thijser/robotica-minor-5/LaTeX/Voorkant_verslag.pdf

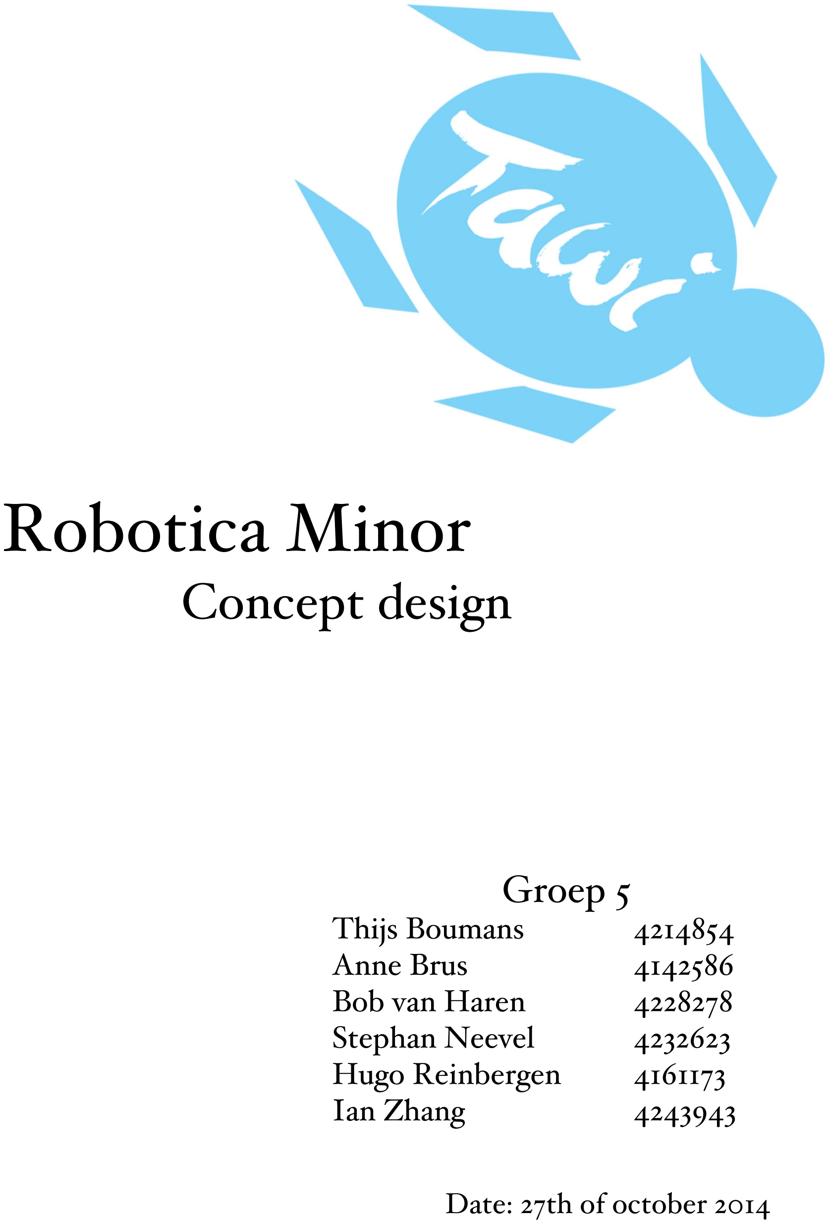
[picture p63: page 1]

# RoboticaM inor

## Concept design

### Groep 5

T hijs Boum ans | 4 214 854
A nne Brus | 414 2586
Bob vanHaren | 4 228278
StephanNeevel | 4 2326 23
Hugo Reinberg en | 4161173
IanZhang | 4 24 394 3

Date:27th ofoctober20 14
