thijser/robotica-minor-5/LaTeX/Images/calculations_mouth.pdf

'' 1

L

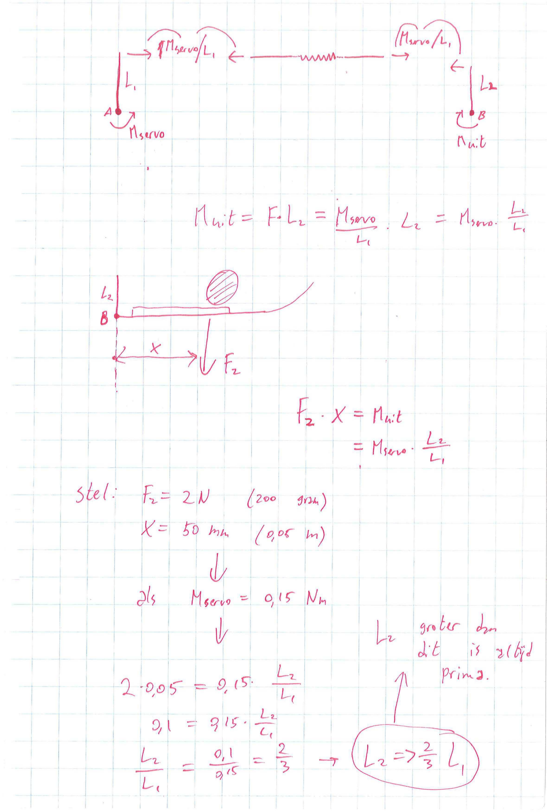
[picture p64: page 1]

— \AAAA /
\AAAA / | f | 4-
u

. L

### A \ l/V O

t

u

. L
lA. (/

# ' ri u 11

(

— | ' ri | u

(

I V | L
u
- \

•
F.
r

# T • \u .it

/ .

f - / -

# [zoo

f - / | - | 1 | 1 Zp | [zoo
1 1 ^'
. | or
J/

i r
ll/
lit ,
O r\ | \ | f

If

JO
U 0 I
i | il l | z
r ^
1 | I

1
