thijser/robotica-minor-5/LaTeX/Images/springproof.pdf

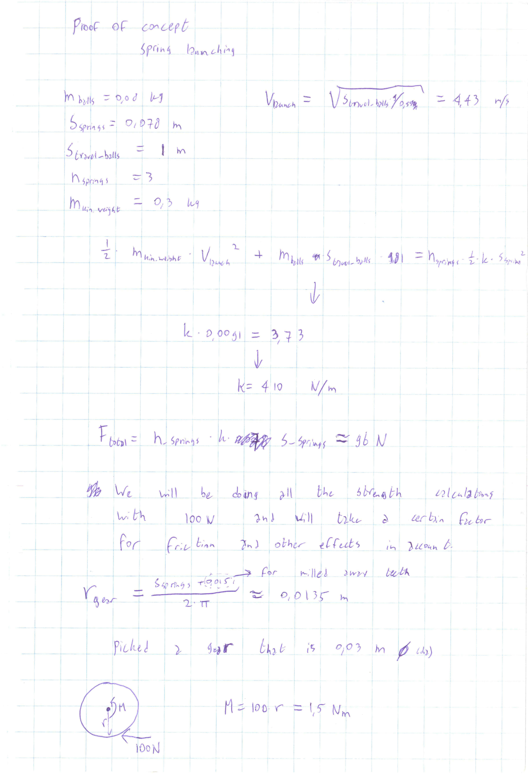
[picture p65: page 1]

of | IP h
H | I | — | ^
lA*) * | -
\ 1

;> it

- h | h | J-

)

3

J
k

f

f t

i | v. :.|L

](

:.|L | I | I
]( | tl

I

fo r | 1 | ohhc

V
> | , | A | tto-

l l

J >
}

100 A

)'
