thijser/robotica-minor-5/LaTeX/Images/truckproof.pdf

\ .

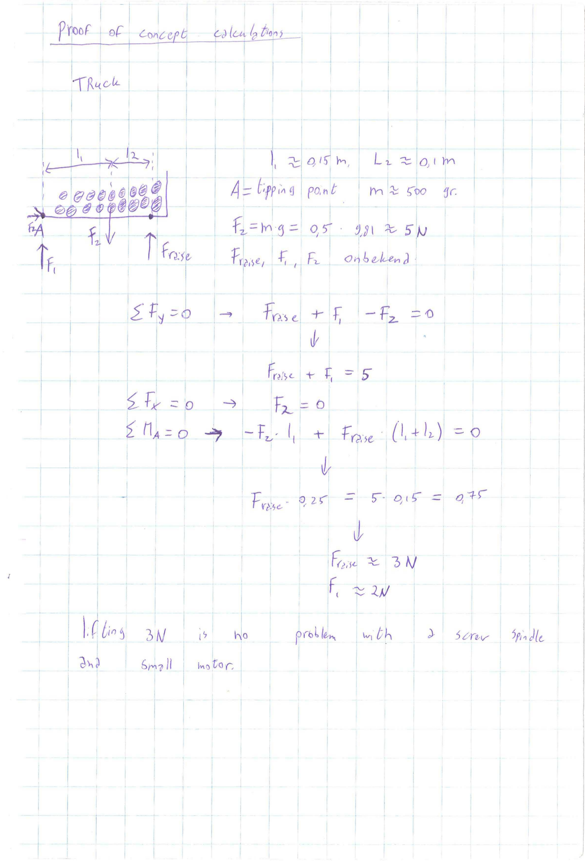
[picture p66: page 1]

i 4 ^'< i >

\ | Q.IS | L

f >^
(
| Q.IS | L
' 11 'J | po, tl | oo \r.
\ | / | U l • ^ 5" KJ • ^ 5" KJ
s | / | * V
f, | F.
r
i f | 2- "

5-
if . 0
- 1,

^ 0

-F , • 1, | Or
J
li/

O, ( i

l

f, ^ | f
if | KI | 0 | f | ^

•

1
