thijser/robotica-minor-5/beaglebone_headers.jpg

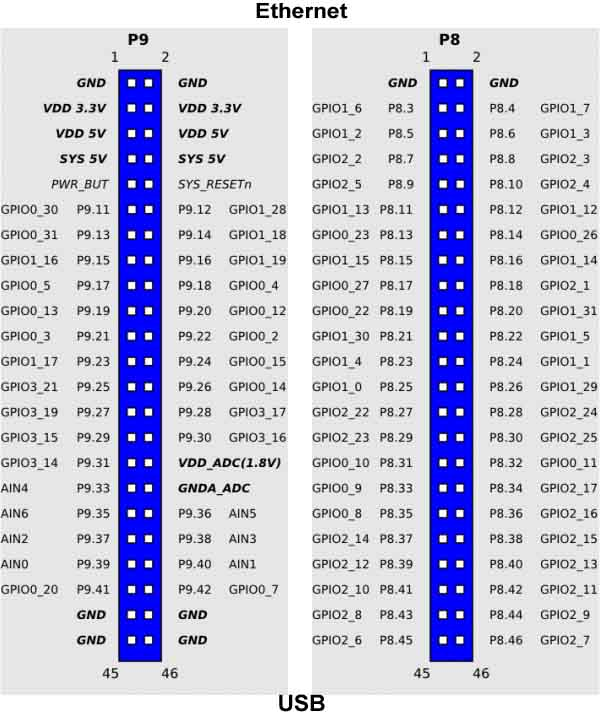
beaglebone_headers.jpg
