thijser/robotica-minor-5/LaTeX/Images/BOM.pdf

Part number | Part name | Dealer | Qty/size | Price/unit (ex. Btw) | Price total
404748 | WormWiel Gearbox 3Nm | Eisses | 1 | 42,3 | € 42,30
T1060 | Trekveer | Alcomex | 3 | 2,45 | € 7,35
9901957 | Microswitch tandheugel | Farnell | 1 | 0,924 | € 0,92
2422228 | Beaglebone black | Farnell | 1 | 47,44 | € 47,44
458599 | Tandwiel M1 30T | ATD | 1 | 3,79 | € 3,79
458039 | Tandheugel M1 500mm | ATD | 1 | 8,93 | € 8,93
83111240 | LCD Screen | iPrototype | 1 | 22,95 | € 22,95
206040 - 89 | NiMh accu 3700mAh, 12V, 45*22*218mm | Conrad | 1 | 44,99 | € 44,99
HE0216-220 | RFID tag sticker 25mm dia. | HobbyElectronica | 20 | 0,95 | € 19,00
801144 | Styropor bal 50mm | Rienda | 20 | 0,12 | € 2,40
HE0136-210 | RFID Reader | HobbyElectronica | 1 | 9,95 | € 9,95
506167 | Trust Bluetooth 3.0 USB Adapter | Dixons | 1 | 9,99 | € 9,99
474-6168 | Timing belt contitech 16 /T5 /550 SS | rs online | 1 | 16,96 | € 16,96
286-5742 | Timing belt pulley aluminium suit belt width 16 | rs online | 2 | 10,58 | € 21,16
298-5391 | DC Geared motor, brushed 6 volt dc 8Ncm 13 rpm | rs online | 1 | 24,82 | € 24,82
586682 | Hoekanker met ril | gamma | 2 | 1,25 | € 2,50
no number | Kitelijn 275kg per meter | CheapKiteLines | 2 | 0,37 | € 0,74
1400-06307X | PVC buis meterstuk [63*2.0] | pvc online | 1 | 2,65 | € 2,65
1426-063063 | PVC T stuk 45 graden [63*63*63] | pvc online | 1 | 10,68 | € 10,68
770-3006 | Hinge 30*30*3 | rs online | 2 | 4,57 | € 9,14
275460 - 89 | Microservo | Conrad | 1 | 5,99 | € 5,99
| PVC Buis 160*2,5 | | 1 | 20 | € 20,00
| PMB Parts | | qty/size/surface
11104 | Glijlager PMB 6-9-11 | PMB | 4 | 0,18 | € 0,72
11105 | Glijlager PMB 8-11-13 | PMB | 3 | 0,2 | € 0,60
11102 | Glijlager PMB 4-6-8 | PMB | 2 | 0,17 | € 0,34
| Perspex plaat 4mm [300*300mm] | Bouwkunde | 0,09 | 105,04 | € 9,45
| Perspex plaat 8mm [600*300mm] | Bouwkunde | 0,18 | 199,87 | € 35,98
71905 | Asborgring PMB 6mm | PMB | 4 | 0,03 | € 0,12
71907 | Asborgring PMB 8mm | PMB | 2 | 0,06 | € 0,12

72115 | Afstandsbus 5,2x10x8 | PMB
| | 1 | 0,08 | € 0,08
60306 | MDF 18 (16 platen van 0.50x0.50) | PMB
| | 4 | 13,4 | € 53,60
30305 | Alu Rondstaf 10 | 0,1 | 1,22 | € 0,12
30305 | Alu Rondstaf 10 | 0,11 | 1,22 | € 0,13
30305 | Alu Rondstaf 10 | 0,12 | 1,22 | € 0,15
30303 | Alu Rondstaf 6 | 0,14 | 0,43 | € 0,06
30217 | Alu Platstaf 20x8 | 0,015 | 2,08 | € 0,03
30405 | Alu Vierkantstaf 25 | 0,02 | 8,57 | € 0,17
30405 | Alu Vierkantstaf 25 | 0,02 | 8,57 | € 0,17
30408 | Alu Vierkantstaf 40 | 0,04 | 21,9 | € 0,88
30408 | Alu Vierkantstaf 40 | 0,02 | 21,9 | € 0,44
30403 | Alu vierkantstaf 15 | 0,04 | 3,09 | € 0,12
30402 | Alu vierkantstaf 10 | 0,06 | 1,38 | € 0,08
30402 | Alu vierkantstaf 10 | 0,1 | 1,38 | € 0,14
30113 | Alu plaat 20 | 0,0072 | 452,03 | € 3,25
30112 | Alu plaat 15 | 0,0128 | 338,82 | € 4,34
30112 | Alu plaat 15 | 0,004 | 338,82 | € 1,36
30112 | Alu plaat 15 | 0,0063 | 338,82 | € 2,13
30110 | Alu plaat 4 | 0,0168 | 81,93 | € 1,38
30105 | Alu plaat 2 | 0,0036 | 29,39 | € 0,11
30105 | Alu plaat 2 | 0,056 | 29,39 | € 1,65
30105 | Alu plaat 2 | 0,0056 | 29,39 | € 0,16
30105 | Alu plaat 2 | 0,0168 | 29,39 | € 0,49
30105 | Alu plaat 2 | 0,0176 | 29,39 | € 0,52
30105 | Alu plaat 2 | 0,0068 | 29,39 | € 0,20
30105 | Alu plaat 2 | 0,0014 | 29,39 | € 0,04
30601 | Alu Buis 15*15*1,5 | 0,035 | 1,44 | € 0,05
30601 | Alu Buis 15*15*1,5 | 0,2 | 1,44 | € 0,29
30601 | Alu Buis 15*15*1,5 | 0,25 | 1,44 | € 0,36
30601 | Alu Buis 15*15*1,5 | 0,25 | 1,44 | € 0,36
30601 | Alu Buis 15*15*1,5 | 0,5 | 1,44 | € 0,72
30601 | Alu Buis 15*15*1,5 | 0,28 | 1,44 | € 0,40
30601 | Alu Buis 15*15*1,5 | 0,29 | 1,44 | € 0,42

50503 | POM plaat 20 | 0,00375 | 897,51 | € 3,37
50503 | POM plaat 20 | 0,003 | 897,51 | € 2,69
51202 | Nitril rubber 2mm | 0,02 | 26,3 | € 0,53
51106 | PS Foam 625*600*80 | 3 | 5,36 | € 16,08

## Own Parts

USB Sound card | Hugo
| | 1 | 0 | € 0,00
Bob's 5 mm perspex plaat [80*60mm] | bob | 0,0048
| | | 0 | € 0,00
Resin en glassfiber voor schild (via kennis) | Anne | € 50,00

# Maybe's:

| Askoppeling 8mm->8mm
| Askoppeling 6mm->4mm
total | € 529,05
