thijser/robotica-minor-5/LaTeX/Images/PartList.pdf

ITEM NO. | PART NUMBER | DESCRIPTION | QTY.
1 | Pioneer-1_Doosje | | 1
2 | MotorWiel_und_enco
der | 2
3 | Afschietbuis | | 1
4 | Wheel_Drive | | 2
5 | Assembly_caster | | 1
6 | Slider_Platform | | 1
7 | containment_ring | | 1
8 | improved_slider_rack
V2 | 1
9 | Top_Cover | | 1
10 | accupack | | 1
11 | BijnaUBeugel | | 2
12 | transportbuis | | 1
13 | pulley 27 T5 12-2 | | 1
14 | Timing belt 16 T5 550 | | 1
15 | Ball | 1
16 | rubber stripje | | 8
17 | T-stuk afgesneden | | 1
18 | nek | 1
19 | motor | | 1
20 | staander achter | | 2
21 | staander voor | | 1
22 | ligger | | 1
23 | ligger platstaf | | 1
24 | ligger 2 | | 1
25 | plaatje voorkant | | 1
26 | ring | 1
27 | Motor-404748-KGK | | 1
28 | motormount | | 1
29 | staander voor rechts | | 1
30 | blokje | | 1
31 | blokje voor
| bevestiging frame | | 4
32 | motordakje | | 1
33 | ISO 1580 - M4 x 10 ---
10N | 8
34 | ISO 1580 - M4 x 40 ---
40N | 5
35 | ISO 1580 - M4 x 20 ---
20N | 4

36 ISO 1580 - M4 x 25 ---
25N

2

37 ISO 1580 - M3 x 10 ---
10N

2

38 ISO 1580 - M3 x 16 ---
16N

2

39 hinge30x30x3

8
40 hinge30x30x3As

4
41 fixatie_pvc_onder

1
42 | ISO 7046-1 - M3 x 10 -
Z --- 10N | 14
43 | ISO 7046-1 - M4 x 16 -
Z --- 16N

4

44 ISO 7046-1 - M3 x 20 -
Z --- 20N

2

45 | Hexagon Nut ISO -
4032 - M3 - D - N | 18
46 | Hexagon Nut ISO -
4032 - M4 - D - N | 15
47 | ligger rechts

1
48 ondersteuningBuis

2
49 hoekanker 90 90
gamma links

1

50 hoekanker 90 90
gamma rechts

1

51 pulley 27 T5 12-2
onder

1

52 ISO 10673-3.2-S

4
53 as pulley beneden

1
54 ISO 7045 - M3 x 8 - Z ---8N

1

55 vierkantas

1
56 Bearing

1
57 Acople Flexible

1
58 Pulleyblockassembly

1
59 assembly_hoofd

1
60 Shell

1
61 shell_fastener

2
62 new_lagerhuis

2
63 glijlager_6_9_11

4
64 axle upper

1
65 houder as boven

2
66 motorbevestiging

1

67 motorhouder_achter

1
68 Acople FlexibleSLDPRT

1
69 B27.7M - 3AM1-6

2
