thijser/robotica-minor-5/(threads)

Thread 2 (2015-01-22):

.save bestanden verwijderen

jensdewaard, 2015-01-22:
Jullie hebben heel veel .save bestanden (tijdelijke bestanden van de nano editor). Dit is raar en zorgt voor een onoverzichtelijke repository. Verwijderen!

bvanharen, 2015-01-22:
Jens ga even je groepsgenoten vervelen ofzo
On 22 Jan 2015 23:45, Jens de Waard <notifications@github.com> wrote:Jullie hebben heel veel .save bestanden (tijdelijke bestanden van de nano editor). Dit is raar en zorgt voor een onoverzichtelijke repository. Verwijderen!

—Reply to this email directly or view it on GitHub.

jensdewaard, 2015-01-22:
Sorry knapperd, ik ben nog niet klaar! Ik heb nog niet eens naar jouw code gekeken.

bvanharen, 2015-01-22:
Haha your eyes will burn. Good luck
On 22 Jan 2015 23:55, Jens de Waard <notifications@github.com> wrote:Sorry knapperd, ik ben nog niet klaar! Ik heb nog niet eens naar jouw code gekeken.

—Reply to this email directly or view it on GitHub.
