thijser/robotica-minor-5/LaTeX/pdfdrawings/Afschietbuis.PDF

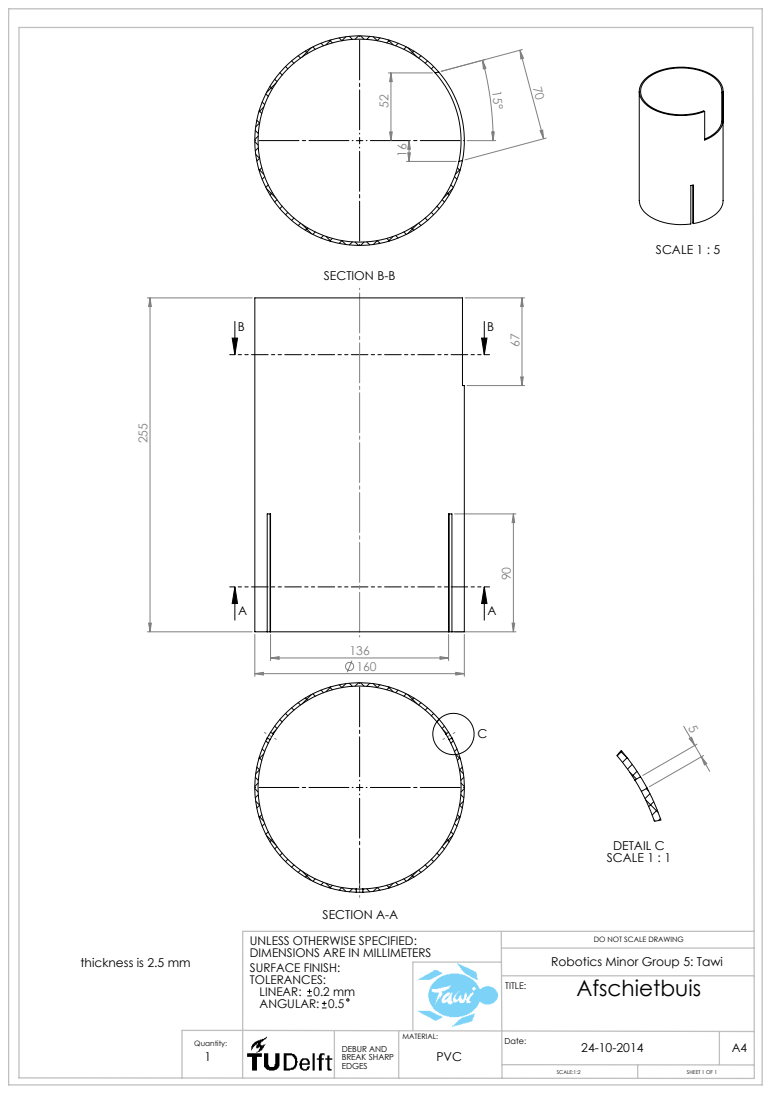
[picture p68: page 1]
SECTION A-A; SCALE 1 : 5; SECTION B-B; DETAIL C SCALE 1 : 1; LINEAR:

UNLESS OTHERWISE SPECIFIED:
DIMENSIONS ARE IN MILLIMETERS
SURFACE FINISH:
TOLERANCES:

DO NOT SCALE DRAWING
Robotics Minor Group 5: Tawi
Afschietbuis

thickness is 2.5 mm

1 | | DEBUR AND BREAK SHARP EDGES | MATERIAL: PVC | Date: 24-10-2014 Quantity: | A4

SCALE:1:2 | SHEET 1 OF 1
