thijser/robotica-minor-5/LaTeX/pdfdrawings/as_pulley_beneden.PDF

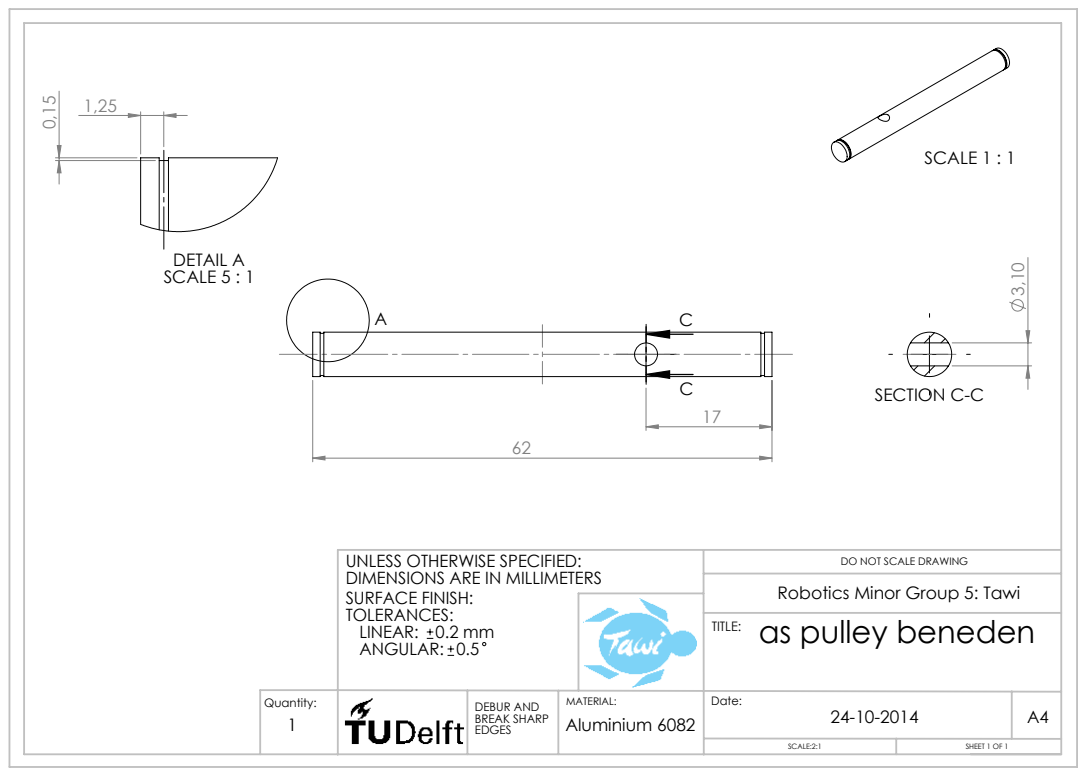
[picture p69: page 1]
DETAIL A SCALE 5 : 1; SECTION C-C; SCALE 1 : 1; LINEAR:

UNLESS OTHERWISE SPECIFIED:
DIMENSIONS ARE IN MILLIMETERS
SURFACE FINISH:
TOLERANCES:

DO NOT SCALE DRAWING
Robotics Minor Group 5: Tawi
as pulley beneden
TITLE:

Quantity: 1 | | DEBUR AND BREAK SHARP EDGES | MATERIAL: Aluminium 6082 | Date: 24-10-2014 | A4

SCALE:2:1 | SHEET 1 OF 1
