thijser/robotica-minor-5/LaTeX/pdfdrawings/blokje.PDF

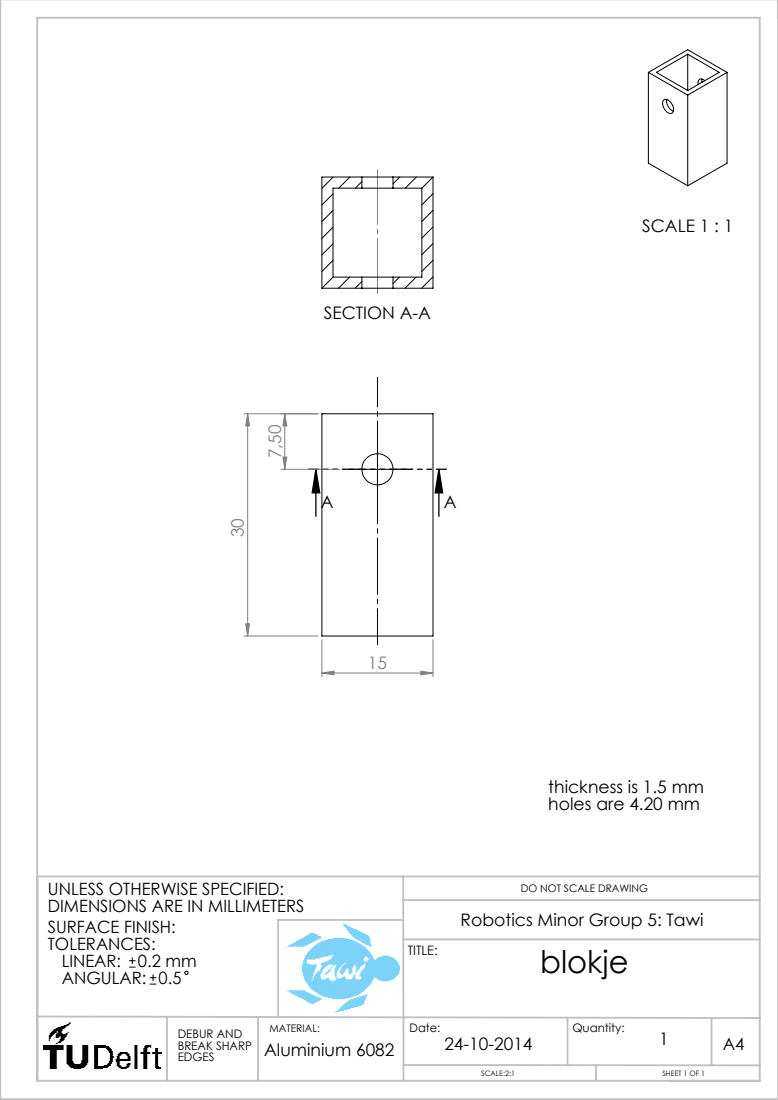
[picture p70: page 1]
SECTION A-A; SCALE 1 : 1; LINEAR:

thickness is 1.5 mm
holes are 4.20 mm

UNLESS OTHERWISE SPECIFIED:
DIMENSIONS ARE IN MILLIMETERS
SURFACE FINISH:
TOLERANCES:

DO NOT SCALE DRAWING
Robotics Minor Group 5: Tawi
blokje

DEBUR AND BREAK SHARP EDGES | MATERIAL: Aluminium 6082 | Date: 24-10-2014 | Quantity: 1 | A4

SCALE:2:1 | SHEET 1 OF 1
