thijser/robotica-minor-5/LaTeX/pdfdrawings/Horizontal_bar_front.PDF

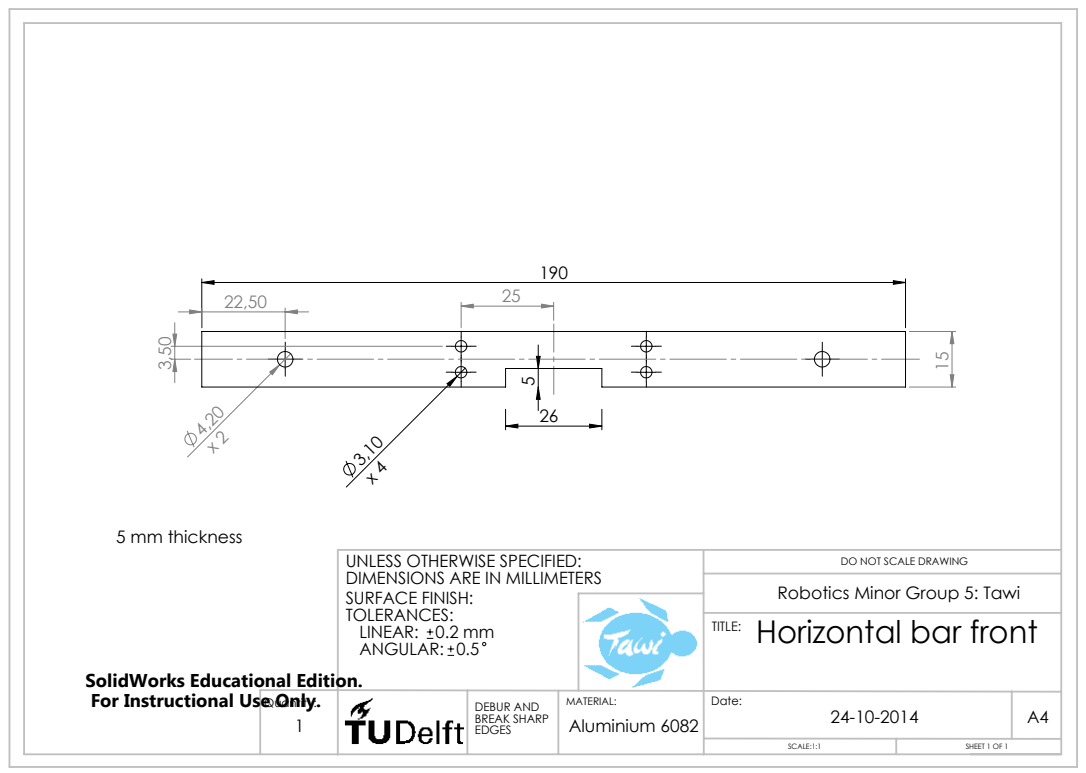
[picture p71: page 1]
5 mm thickness; LINEAR:

UNLESS OTHERWISE SPECIFIED:
DIMENSIONS ARE IN MILLIMETERS
SURFACE FINISH:
TOLERANCES:

DO NOT SCALE DRAWING
Robotics Minor Group 5: Tawi
Horizontal bar front
TITLE:

SolidWorks Educational Edition.
For Instructional Use Only.

Quantity: 1 | | DEBUR AND BREAK SHARP EDGES | MATERIAL: Aluminium 6082 | Date: 24-10-2014 | A4

SCALE:1:1 | SHEET 1 OF 1
