thijser/robotica-minor-5/LaTeX/pdfdrawings/houder_as_boven.PDF

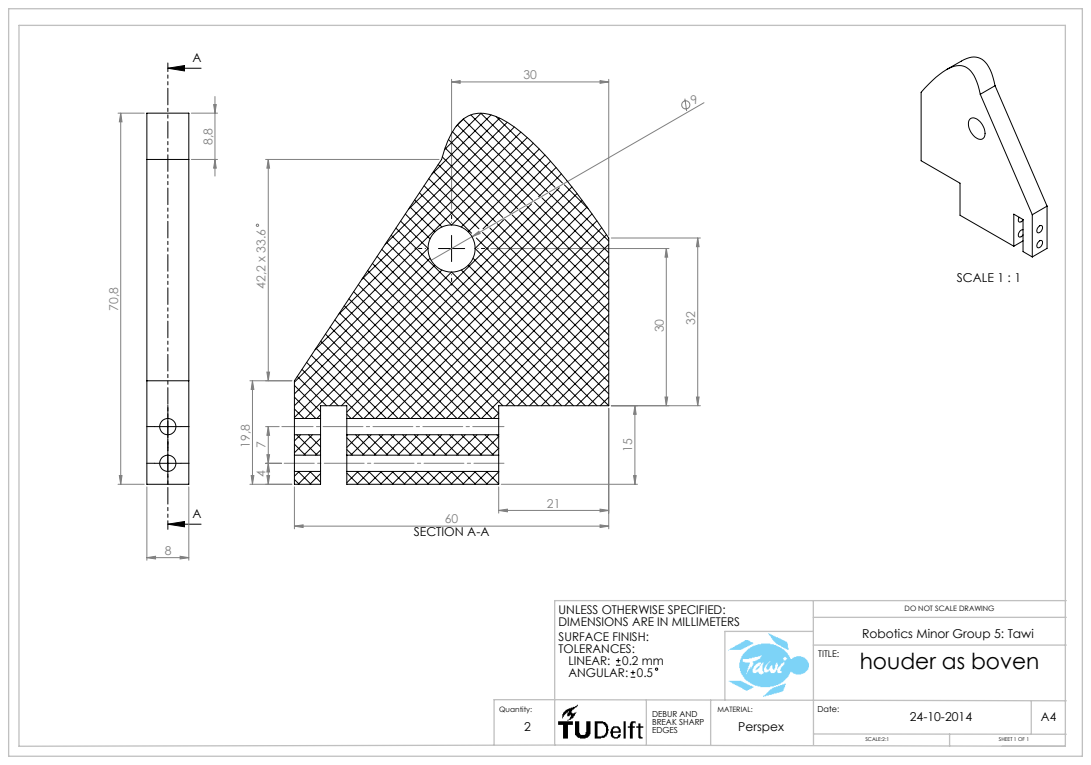
[picture p72: page 1]
SECTION A-A; SCALE 1 : 1; LINEAR:

UNLESS OTHERWISE SPECIFIED:
DIMENSIONS ARE IN MILLIMETERS
SURFACE FINISH:
TOLERANCES:

DO NOT SCALE DRAWING
Robotics Minor Group 5: Tawi
houder as boven

2 | | DEBUR AND BREAK SHARP EDGES | MATERIAL: Perspex | Date: 24-10-2014 Quantity: | A4

SCALE:2:1 | SHEET 1 OF 1
