thijser/robotica-minor-5/LaTeX/pdfdrawings/ligger.PDF

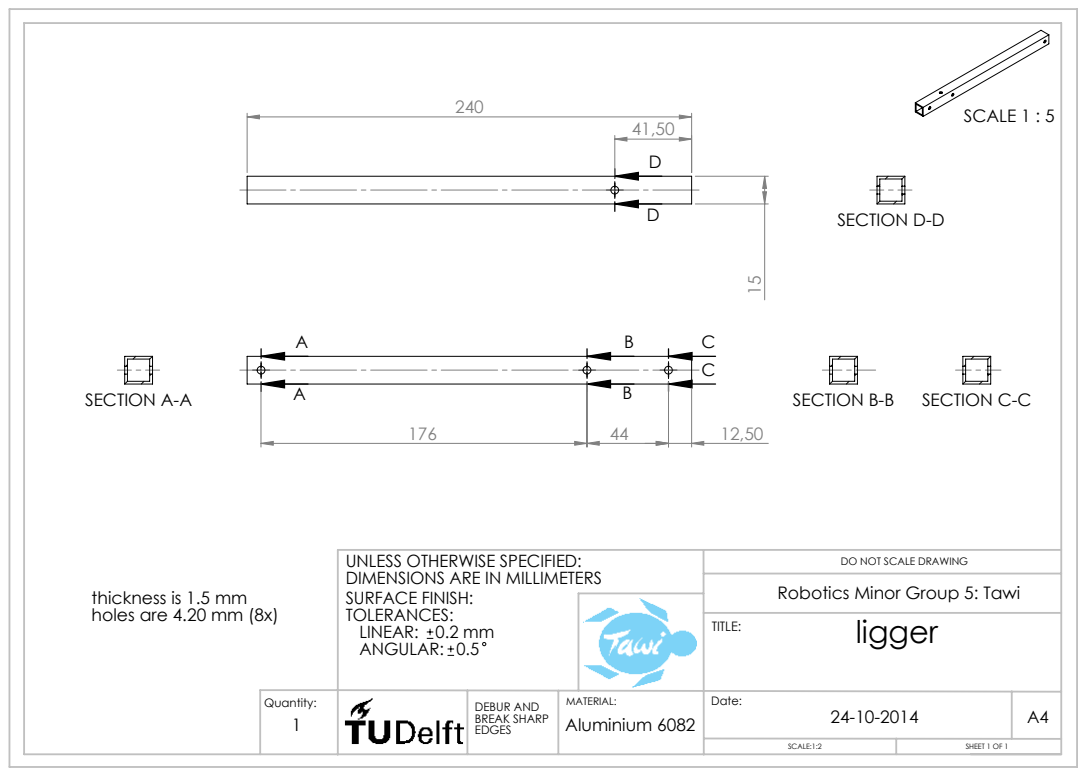
[picture p73: page 1]
SECTION A-A; SECTION B-B SECTION C-C; SECTION D-D; SCALE 1 : 5; holes are 4.20 mm (8x); ligger; LINEAR:

UNLESS OTHERWISE SPECIFIED:
DIMENSIONS ARE IN MILLIMETERS
SURFACE FINISH:
TOLERANCES:

DO NOT SCALE DRAWING
Robotics Minor Group 5: Tawi

thickness is 1.5 mm

Quantity: 1 | | DEBUR AND BREAK SHARP EDGES | MATERIAL: Aluminium 6082 | Date: 24-10-2014 | A4

SCALE:1:2 | SHEET 1 OF 1
