thijser/robotica-minor-5/LaTeX/pdfdrawings/ligger_2.PDF

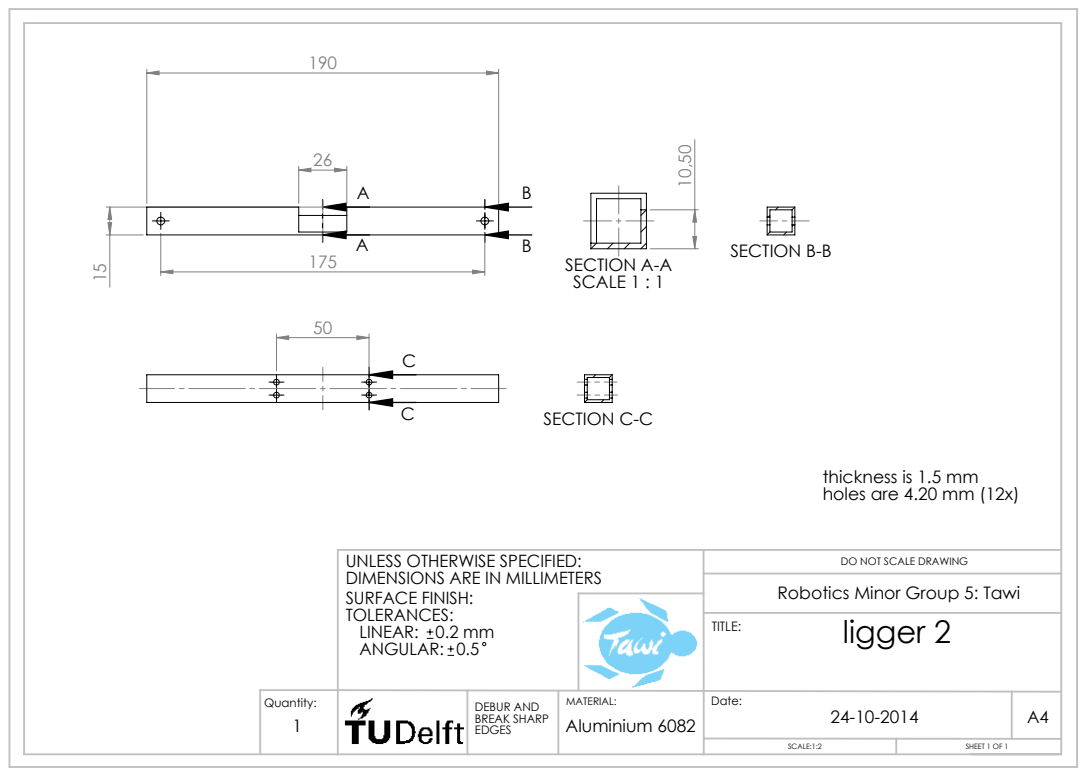
[picture p74: page 1]
SECTION A-A SCALE 1 : 1; SECTION B-B; SECTION C-C; LINEAR:

thickness is 1.5 mm
holes are 4.20 mm (12x)

UNLESS OTHERWISE SPECIFIED:
DIMENSIONS ARE IN MILLIMETERS
SURFACE FINISH:
TOLERANCES:

DO NOT SCALE DRAWING
Robotics Minor Group 5: Tawi
ligger 2

Quantity: 1 | | DEBUR AND BREAK SHARP EDGES | MATERIAL: Aluminium 6082 | Date: 24-10-2014 | A4

SCALE:1:2 | SHEET 1 OF 1
