thijser/robotica-minor-5/LaTeX/pdfdrawings/ligger_rechts.PDF

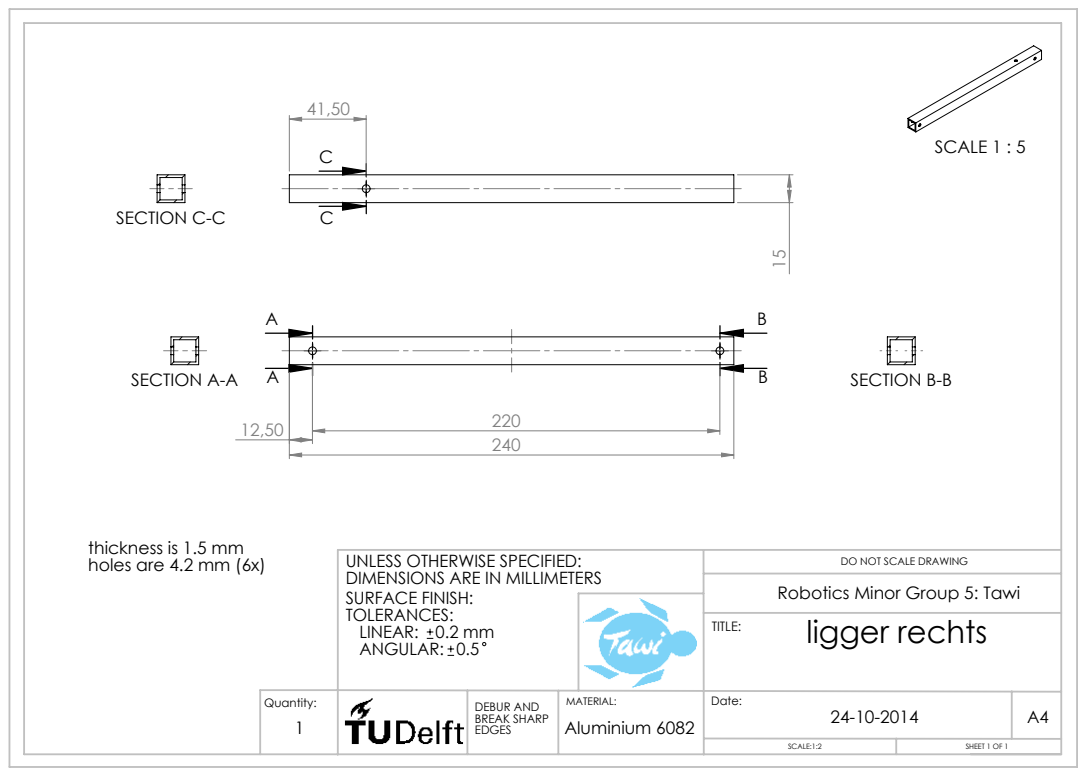
[picture p75: page 1]
SECTION A-A; SECTION B-B; SECTION C-C; SCALE 1 : 5; LINEAR:

thickness is 1.5 mm
holes are 4.2 mm (6x)

UNLESS OTHERWISE SPECIFIED:
DIMENSIONS ARE IN MILLIMETERS
SURFACE FINISH:
TOLERANCES:

DO NOT SCALE DRAWING
Robotics Minor Group 5: Tawi
ligger rechts

Quantity: 1 | | DEBUR AND BREAK SHARP EDGES | MATERIAL: Aluminium 6082 | Date: 24-10-2014 | A4

SCALE:1:2 | SHEET 1 OF 1
