thijser/robotica-minor-5/LaTeX/pdfdrawings/motorbevestiging.PDF

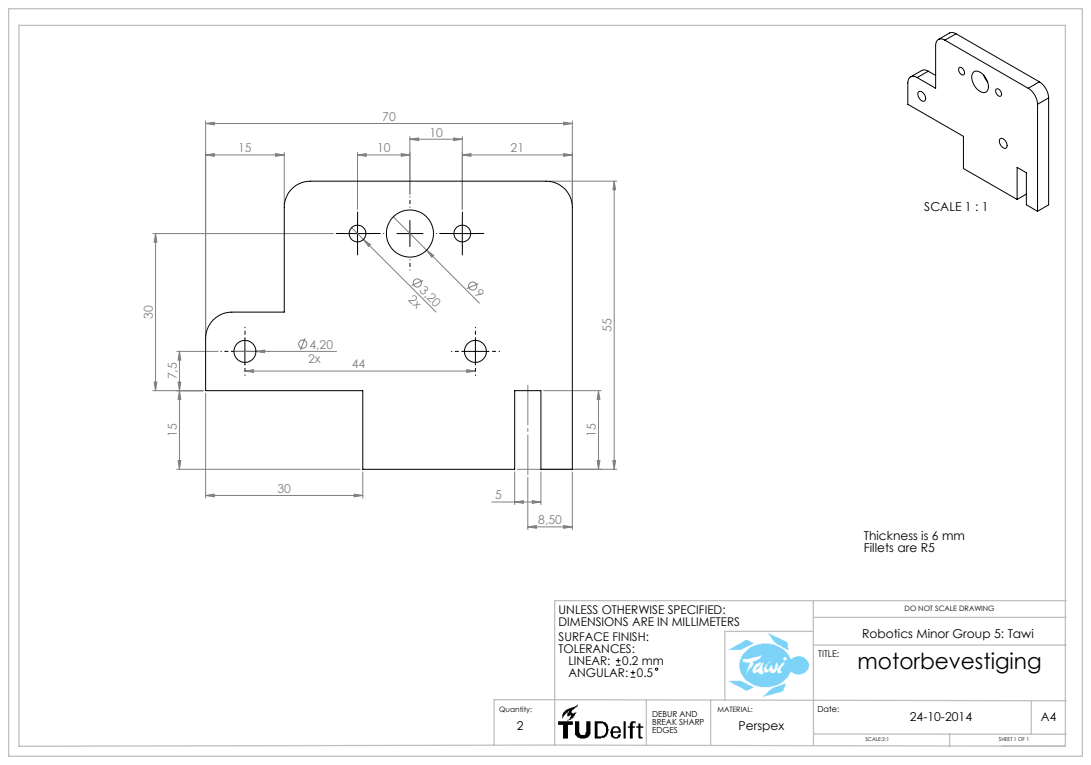
[picture p76: page 1]
SCALE 1 : 1; LINEAR:

Thickness is 6 mm
Fillets are R5

UNLESS OTHERWISE SPECIFIED:
DIMENSIONS ARE IN MILLIMETERS
SURFACE FINISH:
TOLERANCES:

DO NOT SCALE DRAWING
Robotics Minor Group 5: Tawi
motorbevestiging

2 | | DEBUR AND BREAK SHARP EDGES | MATERIAL: Perspex | Date: 24-10-2014 Quantity: | A4

SCALE:2:1 | SHEET 1 OF 1
