thijser/robotica-minor-5/LaTeX/pdfdrawings/motorhouder_achter.PDF

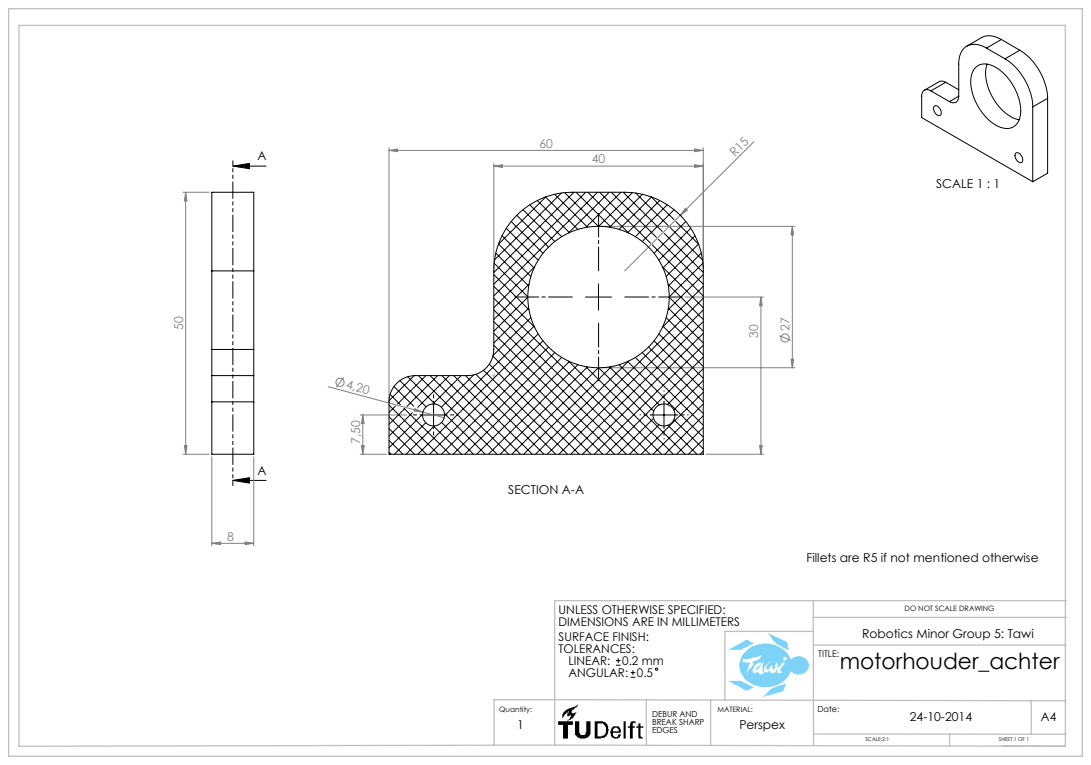
[picture p77: page 1]
SECTION A-A; SCALE 1 : 1; LINEAR:

Fillets are R5 if not mentioned otherwise

UNLESS OTHERWISE SPECIFIED:
DIMENSIONS ARE IN MILLIMETERS
SURFACE FINISH:
TOLERANCES:

DO NOT SCALE DRAWING
Robotics Minor Group 5: Tawi
motorhouder_achter
TITLE:

1 | | DEBUR AND BREAK SHARP EDGES | MATERIAL: Perspex | Date: 24-10-2014 Quantity: | A4

SCALE:2:1 | SHEET 1 OF 1
