thijser/robotica-minor-5/LaTeX/pdfdrawings/ondersteuningBuis.PDF

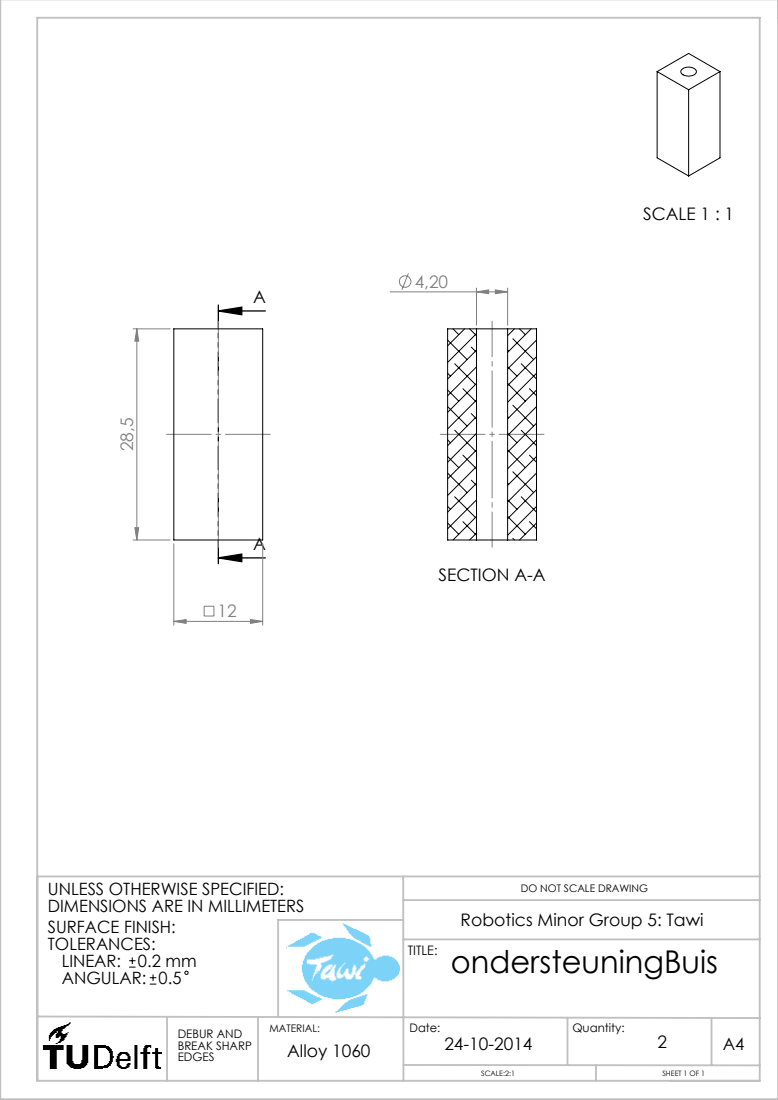
[picture p78: page 1]
SECTION A-A; SCALE 1 : 1; LINEAR:

UNLESS OTHERWISE SPECIFIED:
DIMENSIONS ARE IN MILLIMETERS
SURFACE FINISH:
TOLERANCES:

DO NOT SCALE DRAWING
Robotics Minor Group 5: Tawi
ondersteuningBuis
TITLE:

DEBUR AND BREAK SHARP EDGES | MATERIAL: | Date: 24-10-2014 | Quantity: 2 Alloy 1060 | A4

SCALE:2:1 | SHEET 1 OF 1
