thijser/robotica-minor-5/LaTeX/pdfdrawings/staander_achter.PDF

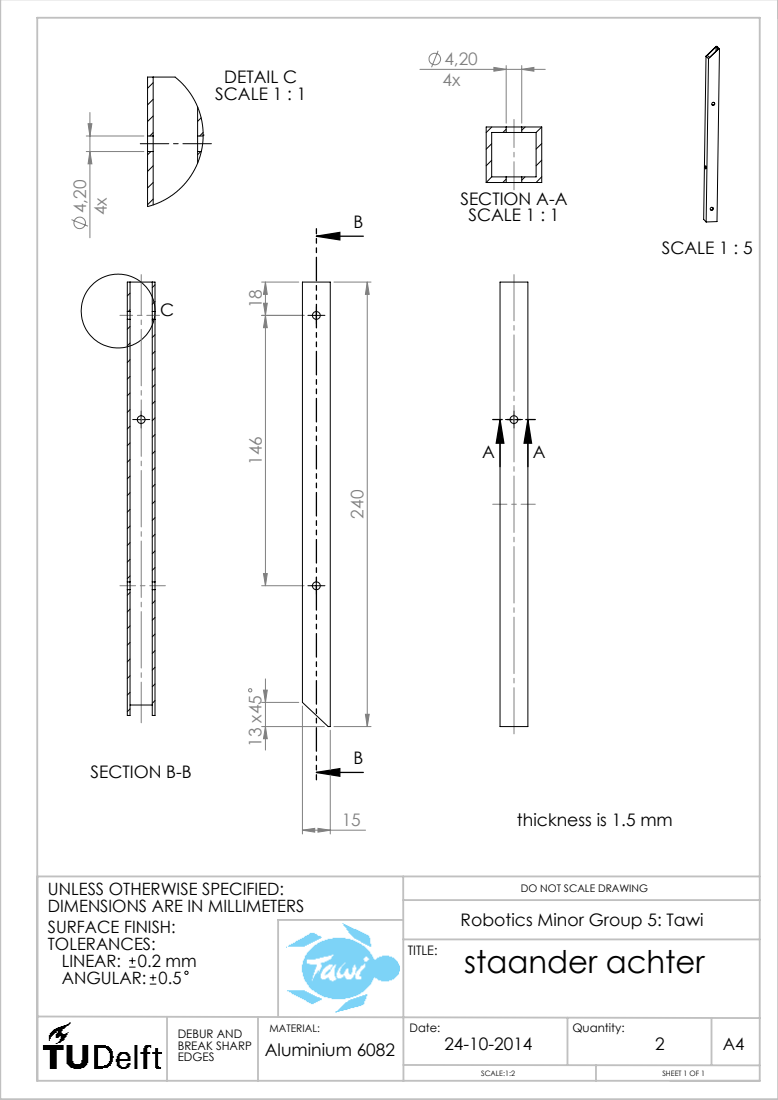
[picture p79: page 1]
SECTION A-A SCALE 1 : 1; SECTION B-B; DETAIL C SCALE 1 : 1; SCALE 1 : 5; LINEAR:

thickness is 1.5 mm

UNLESS OTHERWISE SPECIFIED:
DIMENSIONS ARE IN MILLIMETERS
SURFACE FINISH:
TOLERANCES:

DO NOT SCALE DRAWING
Robotics Minor Group 5: Tawi
staander achter

DEBUR AND BREAK SHARP EDGES | MATERIAL: Aluminium 6082 | Date: 24-10-2014 | Quantity: 2 | A4

SCALE:1:2 | SHEET 1 OF 1
