thijser/robotica-minor-5/LaTeX/pdfdrawings/staander_voor.PDF

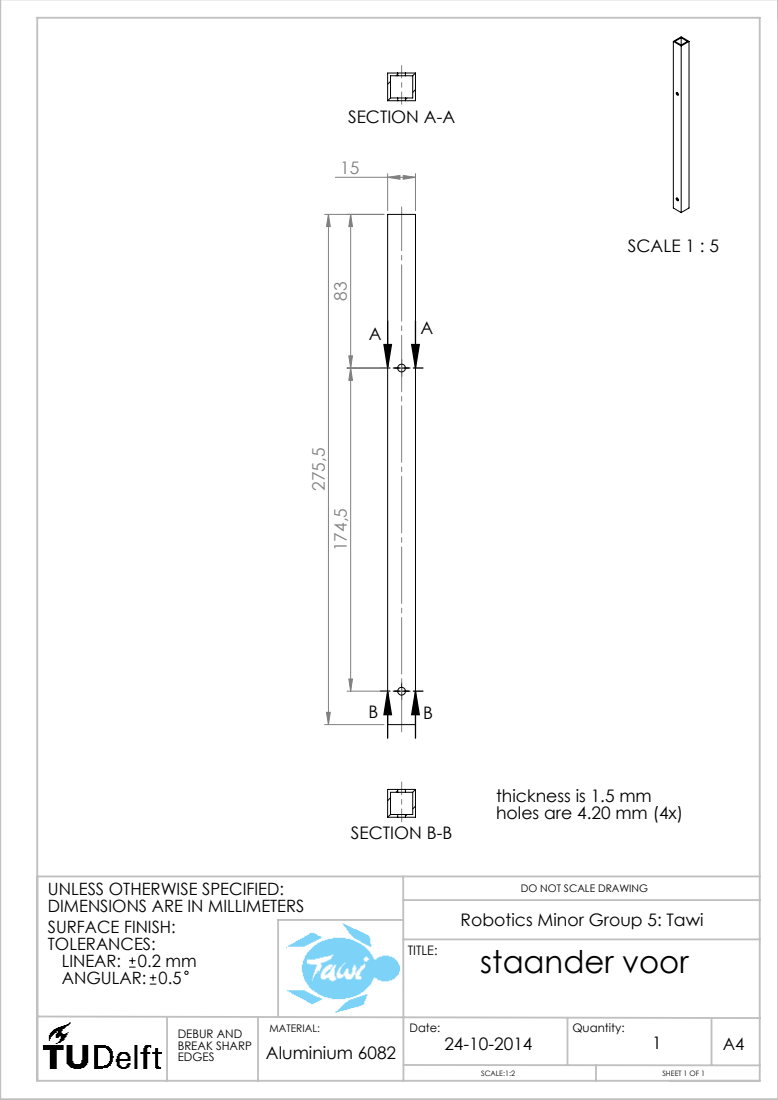
[picture p80: page 1]
SECTION A-A; SECTION B-B; SCALE 1 : 5; LINEAR:

thickness is 1.5 mm
holes are 4.20 mm (4x)

UNLESS OTHERWISE SPECIFIED:
DIMENSIONS ARE IN MILLIMETERS
SURFACE FINISH:
TOLERANCES:

DO NOT SCALE DRAWING
Robotics Minor Group 5: Tawi
staander voor

DEBUR AND BREAK SHARP EDGES | MATERIAL: Aluminium 6082 | Date: 24-10-2014 | Quantity: 1 | A4

SCALE:1:2 | SHEET 1 OF 1
