thijser/robotica-minor-5/LaTeX/pdfdrawings/T-stuk_afgesneden.PDF

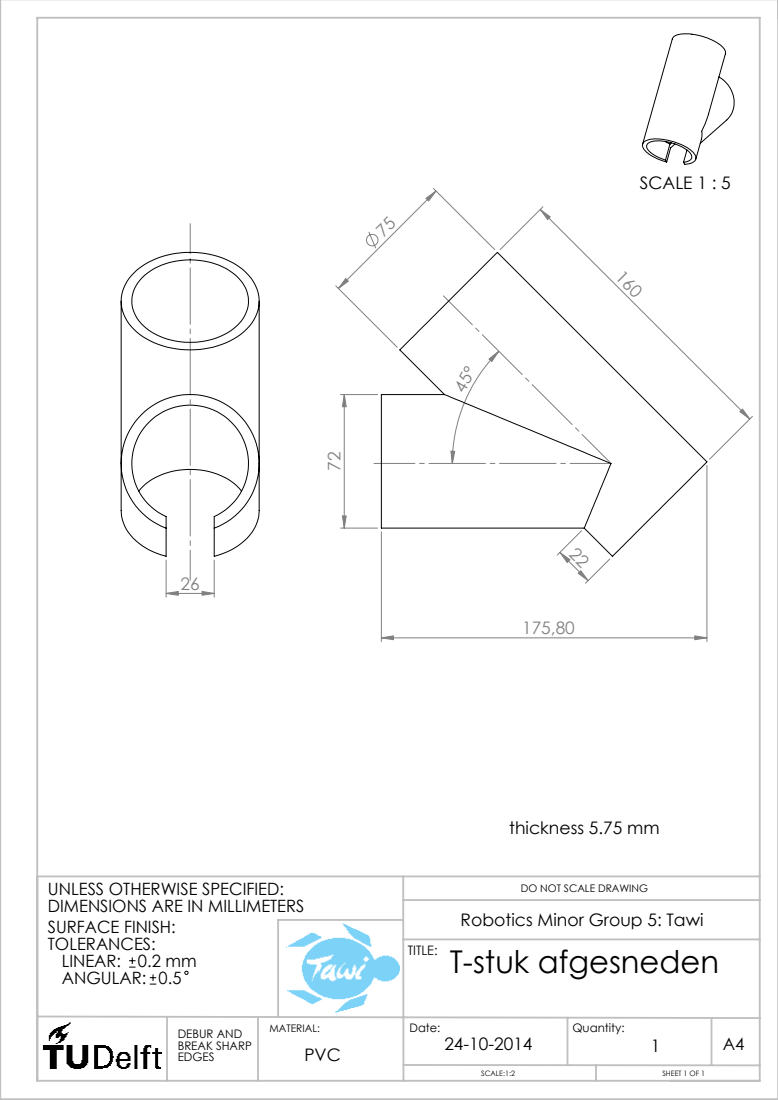
[picture p81: page 1]
SCALE 1 : 5; thickness 5.75 mm; LINEAR:

UNLESS OTHERWISE SPECIFIED:
DIMENSIONS ARE IN MILLIMETERS
SURFACE FINISH:
TOLERANCES:

DO NOT SCALE DRAWING
Robotics Minor Group 5: Tawi
T-stuk afgesneden
TITLE:

DEBUR AND BREAK SHARP EDGES | MATERIAL: PVC | Date: 24-10-2014 | Quantity: 1 | A4

SCALE:1:2 | SHEET 1 OF 1
