thijser/robotica-minor-5/LaTeX/pdfdrawings/transportbuis.PDF

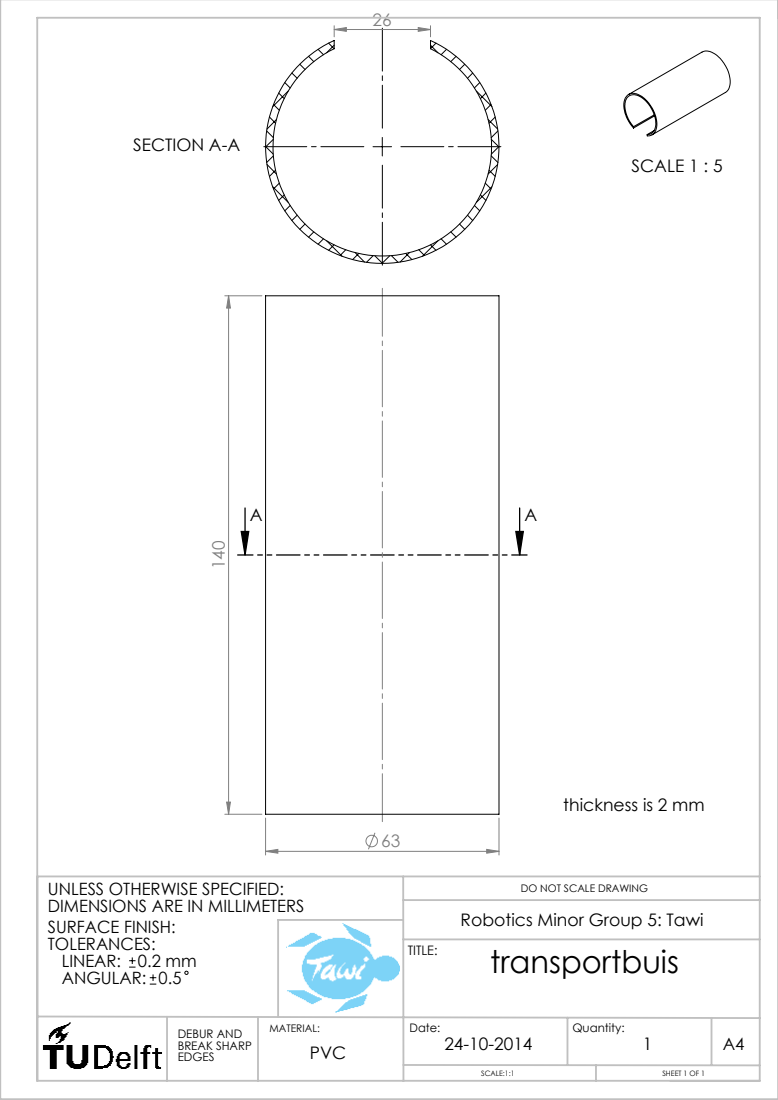
[picture p82: page 1]
SECTION A-A; SCALE 1 : 5; LINEAR:

thickness is 2 mm

UNLESS OTHERWISE SPECIFIED:
DIMENSIONS ARE IN MILLIMETERS
SURFACE FINISH:
TOLERANCES:

DO NOT SCALE DRAWING
Robotics Minor Group 5: Tawi
transportbuis

DEBUR AND BREAK SHARP EDGES | MATERIAL: PVC | Date: 24-10-2014 | Quantity: 1 | A4

SCALE:1:1 | SHEET 1 OF 1
