thijser/robotica-minor-5/turtleCode/src/glados/src/launchManager.h

#ifndef LAUNCHDRIVER_H
#define LAUNCHDRIVER_H

#include <ros/ros.h>
#include <std_msgs/String.h>
#include <std_msgs/Int16.h>
#include <std_msgs/Float32.h>
#include <string.h>
//Ultrasonic
//#include <prussdrv.h>
//#include <pruss_intc_mapping.h>


class LaunchManager{
public:
	void coreCallback(const std_msgs::String::ConstPtr &msg);
	void launchCallback(const std_msgs::Int16::ConstPtr & msg);
	void conveyCallback(const std_msgs::Int16::ConstPtr & msg);
	void init();
	void spin();
	void usCallback(const std_msgs::Float32::ConstPtr & msg);
protected:
	ros::NodeHandle handle;
	ros::Subscriber coreSub;
	ros::Subscriber launchSub;
	ros::Subscriber conveySub;
	ros::Publisher corePub;
	ros::Publisher launchPub;
	ros::Publisher conveyPub;
	ros::Subscriber usSub;
	bool launching = false;
	bool conveying = false;
	bool ultrasoneSafe = false;
};

#endif 
