thijser/robotica-minor-5/turtleCode/arduino/final/LCD12864_test/DFrobot_bmp.h

/*------------------------------------------------------------------------------
; DFrobot bitmap - size 128x64 pixels, black/white image
------------------------------------------------------------------------------*/ 
const PROGMEM unsigned char g0[]={
0x00 ,0x00 ,0x00 ,0x00 ,0x00 
,0x00 ,0x00 ,0x00 ,0x00 ,0x00 
,0x00 ,0x00 ,0x00 ,0x00 ,0x00 
,0x00 ,0x00 ,0x00 ,0x00 ,0x00 
,0x00 ,0x00 ,0x00 ,0x00 ,0x00 
,0x00 ,0x00 ,0x00 ,0x00 ,0x00 
,0x00 ,0x00 ,0x00 ,0x00 ,0x00 
,0x00 ,0x00 ,0x00 ,0x00 ,0x00 
,0x00 ,0x00 ,0x00 ,0x00 ,0x00 
,0x00 ,0x00 ,0x00 ,0x00 ,0x00 
,0x00 ,0x00 ,0xFE ,0x80 ,0x00 
,0x00 ,0x06 ,0xFE ,0xF0 ,0x00 
,0x00 ,0x1E ,0xFE ,0xF8 ,0x00 
,0x00 ,0x3E ,0xFE ,0xFC ,0x00 
,0x00 ,0x7E ,0xFE ,0xFE ,0x00 
,0x00 ,0xFE ,0xFE ,0xFE ,0x00 
,0x00 ,0xFE ,0xC0 ,0xFE ,0x80 
,0x00 ,0xFE ,0x80 ,0xFE ,0x80 
,0x02 ,0xFE ,0x00 ,0x7E ,0xC0 
,0x02 ,0xFE ,0x00 ,0x7E ,0xC0 
,0x06 ,0xFC ,0x00 ,0x3E ,0xC0 
,0x06 ,0xFC ,0x00 ,0x3E ,0xC0 
,0x06 ,0xF8 ,0x00 ,0x3E ,0xE0 
,0x06 ,0xF8 ,0x00 ,0x1E ,0xE0 
,0x0E ,0xF8 ,0x00 ,0x1E ,0xE0 
,0x0E ,0xF0 ,0x00 ,0x1E ,0xE0 
,0x0E ,0xF0 ,0x00 ,0x1E ,0xE0 
,0x0E ,0xF0 ,0x00 ,0x1E ,0xE0 
,0x0E ,0xF0 ,0x00 ,0x1E ,0xE0 
,0x0E ,0xF0 ,0x00 ,0x1E ,0xE0 
,0x1E ,0xE0 ,0x00 ,0x1E ,0xE0 
,0x1E ,0xE0 ,0x00 ,0x1E ,0xE0 
,0x1E ,0xE0 ,0x00 ,0x1E ,0xE0 
,0x1E ,0xE0 ,0x00 ,0x1E ,0xE0 
,0x1E ,0xE0 ,0x00 ,0x1E ,0xE0 
,0x1E ,0xE0 ,0x00 ,0x1E ,0xE0 
,0x1E ,0xE0 ,0x00 ,0x1E ,0xE0 
,0x1E ,0xE0 ,0x00 ,0x1E ,0xE0 
,0x1E ,0xE0 ,0x00 ,0x3E ,0xC0 
,0x0E ,0xE0 ,0x00 ,0x3E ,0xC0 
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

};
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
,0x00 ,0x00 ,0x00 ,0xC0 ,0x06 ,0xFE ,0x60 ,0x80 ,0x0C ,0x7E ,0xF6 ,0x00 ,0x0C ,0x00 ,0x00 ,0x00 
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
};
const unsigned char * const index[]  = {g0,g1,g2,g3,g4,g5,g6,g7,g8,g9,g10,g11,g12,g13,g14,g15,g16,g17,g18,g19,g20,plus,minus,times}; 
