thijser/robotica-minor-5/turtleCode/arduino/final/LCD12864_test/LCD12864RSPI.cpp

/*
  Arduino library v1.0
  Demo LCD12864 spi
  www.dfrobot.com
  Version 0.0
 
  Update in Februray 26th, 2013
  Library is applied to Arduino 1.0
  Having added a "initDriverPin" function that allows users to define the SPI interface
  Version 1.0
*/

#include "LCD12864RSPI.h"
#include <Arduino.h>
#include <avr/pgmspace.h>
//extern "C" 
//{
//#include <wiring.h> 
//#include <inttypes.h>
//#include <stdio.h>  //not needed yet
//#include <string.h> //needed for strlen()
//#include <avr/pgmspace.h>
//}

//
void LCD12864RSPI::initDriverPin(int clock,int latch,int data)
{
  clockPin = clock;
  latchPin = latch;
  dataPin = data;
}

LCD12864RSPI::LCD12864RSPI() 
{
this->DEFAULTTIME = 80; // 80 ms default time
this->delaytime = DEFAULTTIME;
} 

//
void LCD12864RSPI::delayns(void)
{   
delayMicroseconds(delaytime);
 }


void LCD12864RSPI::WriteByte(int dat)
{
	digitalWrite(latchPin, HIGH);
    delayns();
    shiftOut(dataPin, clockPin, MSBFIRST, dat);
    digitalWrite(latchPin, LOW);
}


void LCD12864RSPI::WriteCommand(int CMD)
{
   int H_data,L_data;
   H_data = CMD;
   H_data &= 0xf0;
   L_data = CMD;
   L_data &= 0x0f;
   L_data <<= 4;
   WriteByte(0xf8);
   WriteByte(H_data);
   WriteByte(L_data);
}


void LCD12864RSPI::WriteData(int CMD)
{
   int H_data,L_data;
   H_data = CMD;
   H_data &= 0xf0;
   L_data = CMD;
   L_data &= 0x0f;
   L_data <<= 4;
   WriteByte(0xfa);
   WriteByte(H_data);
   WriteByte(L_data);
}



void LCD12864RSPI::Initialise()
{
	pinMode(latchPin, OUTPUT);     
    pinMode(clockPin, OUTPUT);    
    pinMode(dataPin, OUTPUT);
    digitalWrite(latchPin, LOW);
    delayns();

    WriteCommand(0x30);
    WriteCommand(0x0c);
    WriteCommand(0x01);
    WriteCommand(0x06);
}


void LCD12864RSPI::CLEAR(void)
{  
    WriteCommand(0x30);//
    WriteCommand(0x01);
}


void LCD12864RSPI::DisplayString(int X,int Y,uchar *ptr,int dat)
{
  int i;

  switch(X)
   {
     case 0:  Y|=0x80;break;

     case 1:  Y|=0x90;break;

     case 2:  Y|=0x88;break;

     case 3:  Y|=0x98;break;

     default: break;
   }

  WriteCommand(Y);

  for(i=0;i<dat;i++)
    { 
      WriteData(ptr[i]);
    }
}



void LCD12864RSPI::DisplaySig(int M,int N,int sig)
{
  switch(M)
   {
     case 0:  N|=0x80;break;

     case 1:  N|=0x90;break;

     case 2:  N|=0x88;break;

     case 3:  N|=0x98;break;

     default: break;
   }
  WriteCommand(N);
  WriteData(sig);
 }

unsigned char get_F3(int index,const unsigned char *a,const unsigned char *b,const unsigned char *c){
  unsigned char* ret=0x00;
  if(index%16/5==0){
    memcpy_P(ret,a+(5*((index)/16))+index%16,sizeof(char));
    return *ret;
  }
  if(index%16/5==1){
    memcpy_P(ret,b+(5*((index)/16))+index%16-5,sizeof(char));
    return *ret;
  }
  if(index%16/5==2){
   memcpy_P(ret,c+(5*((index)/16))+index%16-10,sizeof(char));
    return *ret;
  }
  if(index%16/5==3){
    return 0x00;
  }
  return *ret;
}

void LCD12864RSPI::DrawFullScreen_F3(const unsigned char *a, const unsigned char *b,   const unsigned char *c)
{
      int ygroup,x,y,i;
      int temp;
      int tmp;
             
      for(ygroup=0;ygroup<64;ygroup++)           //for each line on the screen 
        {                           
           if(ygroup<32)
            {
             x=0x80;
             y=ygroup+0x80;
            }
           else 
            {
              x=0x88;
              y=ygroup-32+0x80;    
            }         
           WriteCommand(0x34);        //clock 
           WriteCommand(y);           //position y 
           WriteCommand(x);           //position x 
           WriteCommand(0x30);        //here comes a  pixel
           tmp=ygroup*16;
           for(i=0;i<16;i++)
		 {
		    temp=get_F3(tmp++,a,b,c);
		    WriteData(temp);
               }
          }
        WriteCommand(0x34);        //display 
        WriteCommand(0x36);        //ready 
}

void LCD12864RSPI::DrawFullScreen(const uchar *p)
{
      int ygroup,x,y,i;
      int temp;
      int tmp;
      int* tempp;
      
      for(ygroup=0;ygroup<64;ygroup++)
        {
           if(ygroup<32)
            {
             x=0x80;
             y=ygroup+0x80;
            }
           else 
            {
              x=0x88;    
              y=ygroup-32+0x80;    
            }         
           WriteCommand(0x34);
           WriteCommand(y);
           WriteCommand(x);
           WriteCommand(0x30);
           tmp=ygroup*16;
           tempp=(int*)malloc(sizeof(int));
           for(i=0;i<16;i++)
		 {
                    memcpy_P(tempp,p+(tmp++*sizeof(uchar)),sizeof(byte));
                    
		    WriteData(*tempp);
               }
          }
        free(tempp);
        WriteCommand(0x34);
        WriteCommand(0x36);
}



void LCD12864RSPI::img1(uchar img[])
{
    unsigned int i;
    unsigned char page,column;  

    for(page=0xB0;page<0xB4;page++)  
    {  
        WriteCommand(page);  //set page address   
        WriteCommand(0x10);  //set Column address MSB   
        WriteCommand(0x04);  //set column address LSB 
        
        i = (0xB3-page)*128;
        
        for(column=0;column<128;column++)  
        {  
            WriteData(~img[i+column]);  
        } 
    } 
        WriteCommand(0x34);
        WriteCommand(0x36);
}

void LCD12864RSPI::img2(uchar img[])
{
    unsigned int i;
    unsigned char page,column;  

    for(page=0xB4;page<0xB8;page++)  
    {  
        WriteCommand(page);  //set page address   
        WriteCommand(0x10);  //set Column address MSB   
        WriteCommand(0x04);  //set column address LSB 
        
        i = (0xB7-page)*128;
        
        for(column=0;column<128;column++)  
        {  
            WriteData(~img[i+column]);  
        } 
    }  
        WriteCommand(0x34);
        WriteCommand(0x36);
}



LCD12864RSPI LCDA = LCD12864RSPI();
