thijser/robotica-minor-5/(commit log)

2014-10-20 added base code for arduino ultrasound sensor, should still be calibrated
2014-10-20 calibrated sensor to now work in mm rather then inch
2014-10-22 base for multisone, doesn't work yet?
    [model-1_2.sdf, model-1_3.sdf, model-1_4.sdf, model.sdf]
2014-10-24 verslag tot en met Battery
2014-10-26 Opnieuw 14.1 geschreven die for some reason niet opsloeg, andere shit gefixed
2014-10-27 shit in de summary die wrs voor conflicts gaat zorgen
2014-11-10 start of core fixes.
    [core.cpp]
2014-11-18 Drivers! Still have to fix header include of switchSensor.h in conveyorDriver. CURRENTLY DOES NOT BUILD.
    [audioDriver.cpp, conveyorDriver.cpp, switchSensor.cpp, switchSensor.h]
2014-11-20 Fixed linking of conveyorDriver and switchSensor. Back to compiling build.
    [conveyorDriver.cpp, drivingDriver.cpp, switchSensor.cpp, switchSensor.h]
2014-11-20 All sensor class structures are now implemented. Waiting for the actual hardware.
2014-12-02 beaglebone pin layout
2014-12-04 added arduino
2014-12-09 Fixed swapped 0 and 1 for inverted beaglebone logic.
    [launchDriver.cpp]
2014-12-09 Added switchsensor for BBB (port 60)
2014-12-10 rechanged some arduino stuff
2014-12-10 SwitchSensor and launchmotor communication.
2014-12-10 Launch + Switch now working as intended!
2014-12-11 Updates to launch + switch communication.
2014-12-15 temp driver mover to BBB
2014-12-15 build drivers?
2014-12-18 Final code for arduino fixed.
    [DFrobot_bmp.h, LCD12864RSPI.cpp, LCD12864RSPI.h, LCD12864_test.ino, MFRC522.cpp]
2014-12-18 For setting up the servo and various tests
2015-01-06 killed fingersnapper
2015-01-06 improved fingersnapper
2015-01-06 DrivingDriver can now drive DPR4. Path to config file (found in drivers.launch) is NOT RELATIVE!
2015-01-06 LaunchDriver now gives feedback to launchManager. LaunchManager relays this to core.
2015-01-06 ConveyorDriver now gives feedback to launchManager. ConveyorDriver now sleeps for 20 seconds while it is moving!
2015-01-08 Added second switch and updated comunication to support it. New message: /tawi/core/ballcount
2015-01-08 Fixed port numbers on sensors and drivers.
    [switchSensor.cpp]
2015-01-08 changed balls in arduino
2015-01-09 Updated launchsequence. Double fire still doesn't work.
    [launchDriver.cpp, launchDriver.h]
2015-01-12 Fixed a couple compilation errors.
    [launchDriver.cpp, launchDriver.h, launchManager.cpp]
2015-01-12 Attempted fix for launching twice. NOT YET TESTED
    [launchDriver.cpp, launchDriver.h]
2015-01-12 Properly commented on launchDriver.cpp Attempted to fix double launch.
    [launchDriver.cpp, launchDriver.h]
2015-01-13 Compilation errors in newCore
    [newCore.cpp]
2015-01-13 Removed inversion of bits in switchSensors.
2015-01-13 small tweaks to fix com
    [newCore.cpp, serialListener.cpp]
2015-01-13 Increased publish rates of switchSensors.
2015-01-14 small fix to math asker
    [mathAsker.cpp, newCore.cpp]
2015-01-14 fixed some conc issues
    [mathAsker.cpp, newCore.cpp]
2015-01-15 arduino update
2015-01-16 Removed prints
2015-01-16 UNSTABLE COMMIT intermediate testing changes.
    [conveyorDriver.cpp, endSwitchSensor.cpp]
2015-01-16 More feedback prints.
2015-01-16 ascii print
2015-01-19 added test for connection arduino side
2015-01-20 Gave launchManager support for ultrasonic sensors... sort of DOES NOT COMPILE OUTSIDE BBB
2015-01-20 improved servo values
2015-01-20 arduino changes
2015-01-20 Added ultrasone sensor nodes
2015-01-21 small fix arduino
2015-01-22 More printing statements
2015-01-22 more attempted fixes for serial
    [serialListener.cpp]
2015-01-22 Improved message filter statement
2015-01-23 fixed the boot weirdness
    [LCD12864_test.h, LCD12864_test.ino]
2015-01-23 fixed math asker 1d substraction bug ignoring aviable balls
    [mathAsker.cpp, newCore.cpp]
2015-01-23 Launch should now wait for conveyor to be done
2015-01-23 Attempting to fix waiting for coveyor
    [launchDriver.cpp, launchManager.cpp]
2015-01-23 fixed %0 error in substract2dig()
    [mathAsker.cpp]
2015-01-23 Sped up ballcount. UNSTABLE COMMIT.
    [mathAsker.cpp, newCore.cpp]
2015-01-26 fixed ac. insert nameserver
    [drivingDriver.cpp]
2015-01-26 Attempt to fix freeze during launch
    [launchDriver.cpp, newCore.cpp]
2015-01-26 Unstable attempt to fix ultrasone
    [launchDriver.cpp]
2015-01-26 Wrong counter now resets upon right answer
    [LCD12864_test.ino]
2015-01-27 small fix to mathAsker
    [mathAsker.cpp]
2015-01-27 another small fix to mathaskwer
    [mathAsker.cpp]
2015-01-27 trying to fix duplicate launches
    [UltrasoneSensor.cpp, launchDriver.h, newCore.cpp]
2015-01-27 many changes to fix numerous testing issues
    [UltrasoneSensor.cpp, launchDriver.cpp, launchManager.cpp, newCore.cpp]
2015-01-28 removed callback prints
2015-01-28 arduino fix
